GotesSCoop/ttn-boat-sensor/main/main.ino

/*

  Main module

  # Modified by Kyle T. Gabriel to fix issue with incorrect GPS data for TTNMapper

  Copyright (C) 2018 by Xose Pérez <xose dot perez at gmail dot com>

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
*/

#include "configuration.h"
#include "rom/rtc.h"
#include <TinyGPSPlus.h>
#include <Wire.h>
#include "DHT.h"


#include "axp20x.h"
AXP20X_Class axp;

DHT dht(DHTPIN, DHTTYPE);

bool pmu_irq = false;
String baChStatus = "No charging";

bool ssd1306_found = false;
bool axp192_found = false;

bool packetSent, packetQueued;
bool batt_connected = false;

float humidity;
float temp;
uint8_t switch_status;

static uint8_t txBuffer[10];

// deep sleep support
RTC_DATA_ATTR int bootCount = 0;
esp_sleep_source_t wakeCause;  // the reason we booted this time

// -----------------------------------------------------------------------------
// Application
// -----------------------------------------------------------------------------

float battVolt;

void buildPacket(uint8_t txBuffer[10])
/*
 * Packet structure is as follows
 * Bits 0..23 -> Latitude
 * Bits 24..47 -> Longitude
 * Bit 48 -> GPS Valid
 * Bits 49..55 -> Humidity
 * Bits 56..61 -> Temperature
 * Bit 62 -> Batery ON
 * Bit 63 -> Switch ON
 * Bits 64..71 -> Voltage battery
 * Bits 72..79 -> Not used
 */
{

    uint32_t LatitudeBinary;
    uint32_t LongitudeBinary;
    uint8_t hdopGps;
    uint8_t sats;
    
    uint8_t gpsValid;

    uint8_t humidityBinary;
    uint8_t tempBinary;
    float lowesttemp = -5;

    uint16_t vsens1 = 0;
    uint16_t vsens2 = 0;
    uint8_t battBinary;
    uint8_t battOn;
    
    char t[32]; // used to sprintf for Serial output

    // Battery
    battBinary = uint8_t(battVolt * 10);
    if (batt_connected) battOn = 1; else battOn=0;
    
    // GPS
    LatitudeBinary = ((gps_latitude() + 90) / 180.0) * 16777215;
    LongitudeBinary = ((gps_longitude() + 180) / 360.0) * 16777215;
    
    if ((gps_hdop() < 50.0) and batt_connected) gpsValid = 1; else gpsValid = 0;

    // DHT22     
    humidityBinary = (uint8_t)round(humidity);
    tempBinary = (uint8_t)(round(temp)-lowesttemp);

    // DEBUG
    sprintf(t, "GPS Valid: %d", gpsValid);
    Serial.println(t);
    sprintf(t, "Lat: %f", gps_latitude());
    Serial.println(t);
    sprintf(t, "Lng: %f", gps_longitude());
    Serial.println(t);
    sprintf(t, "Switch Status: %d", switch_status);
    Serial.println(t);
    sprintf(t, "Humidity Binary: %d", humidityBinary);
    Serial.println(t);    
    sprintf(t, "Humidity: %f", humidity);
    Serial.println(t);
    sprintf(t, "Temperature Binary: %d", tempBinary);
    Serial.println(t);  
    sprintf(t, "Temperature: %f", temp);
    Serial.println(t);
    sprintf(t, "Voltage sensor 1 IN : %f",  battVolt);
    Serial.println(t);  
    sprintf(t, "Batt Binary: %i", battBinary);
    Serial.println(t);  
    sprintf(t, "Batt On: %i", battOn);
    Serial.println(t);

    uint8_t txbfdbg = ((gpsValid<<7) & 0x80) | (humidityBinary & 0x7F);
    Serial.printf("TX BUFF 6: %i\n", txbfdbg);
    txbfdbg = ((tempBinary<<2) & 0xFC) | ((battOn << 1) & 0x02) | ((switch_status) & 0x01) ;
    Serial.printf("TX BUFF 7: %i\n", txbfdbg);
    
    // PACKET CREATION
    txBuffer[0] = ( LatitudeBinary >> 16 ) & 0xFF;
    txBuffer[1] = ( LatitudeBinary >> 8 ) & 0xFF;
    txBuffer[2] = LatitudeBinary & 0xFF;
    txBuffer[3] = ( LongitudeBinary >> 16 ) & 0xFF;
    txBuffer[4] = ( LongitudeBinary >> 8 ) & 0xFF;
    txBuffer[5] = LongitudeBinary & 0xFF;
    txBuffer[6] = ((gpsValid<<7) & 0x80) | (humidityBinary & 0x7F);
    txBuffer[7] = ((tempBinary<<2) & 0xFC) | ((battOn << 1) & 0x02) | ((switch_status) & 0x01) ;
    txBuffer[8] = battBinary;
    txBuffer[9] = 0x6A;
    
}

/**
 * If we have a valid position send it to the server.
 * @return true if we decided to send.
 */
bool trySend() {
    packetSent = false;
    char buffer[40];
    
    // Check if we send GPS data, only switch data, or both
    if (isGPSReady() or batt_connected==false){
      if (batt_connected == true){
        Serial.println("Gps wait done");
        snprintf(buffer, sizeof(buffer), "Latitude: %10.6f\n", gps_latitude());
        screen_print(buffer);
        snprintf(buffer, sizeof(buffer), "Longitude: %10.6f\n", gps_longitude());
        screen_print(buffer);
      }
      
      #if LORAWAN_CONFIRMED_EVERY > 0
        bool confirmed = (ttn_get_count() % LORAWAN_CONFIRMED_EVERY == 0);
        if (confirmed){ Serial.println("confirmation enabled"); }
      #else
        bool confirmed = false;
      #endif
            
      buildPacket(txBuffer);
      packetQueued = true;
      ttn_send(txBuffer, sizeof(txBuffer), LORAWAN_PORT, confirmed);
      
      return true;
    } else {
      // Inputs are not ready. Not sending anything yet
      return false;
    }
}


void doDeepSleep(uint64_t msecToWake)
{
    Serial.printf("Entering deep sleep for %llu seconds\n", msecToWake / 1000);

    // not using wifi yet, but once we are this is needed to shutoff the radio hw
    // esp_wifi_stop();

    screen_off();  // datasheet says this will draw only 10ua
    LMIC_shutdown();  // cleanly shutdown the radio
    
    if(axp192_found) {
        // turn on after initial testing with real hardware
        axp.setPowerOutPut(AXP192_LDO2, AXP202_OFF);  // LORA radio
        axp.setPowerOutPut(AXP192_LDO3, AXP202_OFF);  // GPS main power
    }

    // FIXME - use an external 10k pulldown so we can leave the RTC peripherals powered off
    // until then we need the following lines
    esp_sleep_pd_config(ESP_PD_DOMAIN_RTC_PERIPH, ESP_PD_OPTION_ON);

    // Only GPIOs which are have RTC functionality can be used in this bit map: 0,2,4,12-15,25-27,32-39.
    uint64_t gpioMask = (1ULL << BUTTON_PIN);

    // FIXME change polarity so we can wake on ANY_HIGH instead - that would allow us to use all three buttons (instead of just the first)
    gpio_pullup_en((gpio_num_t) BUTTON_PIN);

    esp_sleep_enable_ext1_wakeup(gpioMask, ESP_EXT1_WAKEUP_ALL_LOW);

    esp_sleep_enable_timer_wakeup(msecToWake * 1000ULL);  // call expects usecs
    esp_deep_sleep_start();                               // TBD mA sleep current (battery)
}


void sleep() {
#if SLEEP_BETWEEN_MESSAGES

    // If the user has a screen, tell them we are about to sleep
    if (ssd1306_found) {
        // Show the going to sleep message on the screen
        char buffer[20];
        snprintf(buffer, sizeof(buffer), "Sleeping in %3.1fs\n", (MESSAGE_TO_SLEEP_DELAY / 1000.0));
        screen_print(buffer);

        // Wait for MESSAGE_TO_SLEEP_DELAY millis to sleep
        delay(MESSAGE_TO_SLEEP_DELAY);

        // Turn off screen
        screen_off();
    }

    // Set the user button to wake the board
    sleep_interrupt(BUTTON_PIN, LOW);

    // We sleep for the interval between messages minus the current millis
    // this way we distribute the messages evenly every SEND_INTERVAL millis
    uint32_t sleep_for = (millis() < SEND_INTERVAL) ? SEND_INTERVAL - millis() : SEND_INTERVAL;
    doDeepSleep(sleep_for);

#endif
}


void callback(uint8_t message) {
    bool ttn_joined = false;
    if (EV_JOINED == message) {
        ttn_joined = true;
    }
    if (EV_JOINING == message) {
        if (ttn_joined) {
            screen_print("TTN joining...\n");
        } else {
            screen_print("Joined TTN!\n");
        }
    }
    if (EV_JOIN_FAILED == message) screen_print("TTN join failed\n");
    if (EV_REJOIN_FAILED == message) screen_print("TTN rejoin failed\n");
    if (EV_RESET == message) screen_print("Reset TTN connection\n");
    if (EV_LINK_DEAD == message) screen_print("TTN link dead\n");
    if (EV_ACK == message) screen_print("ACK received\n");
    if (EV_PENDING == message) screen_print("Message discarded\n");
    if (EV_QUEUED == message) screen_print("Message queued\n");

    // We only want to say 'packetSent' for our packets (not packets needed for joining)
    if (EV_TXCOMPLETE == message && packetQueued) {
        screen_print("Message sent\n");
        packetQueued = false;
        packetSent = true;
    }

    if (EV_RESPONSE == message) {
        screen_print("[TTN] Response: ");

        size_t len = ttn_response_len();
        uint8_t data[len];
        ttn_response(data, len);

        char buffer[6];
        for (uint8_t i = 0; i < len; i++) {
            snprintf(buffer, sizeof(buffer), "%02X", data[i]);
            screen_print(buffer);
        }
        screen_print("\n");
    }
}


void scanI2Cdevice(void)
{
    byte err, addr;
    int nDevices = 0;
    for (addr = 1; addr < 127; addr++) {
        Wire.beginTransmission(addr);
        err = Wire.endTransmission();
        if (err == 0) {
            Serial.print("I2C device found at address 0x");
            if (addr < 16)
                Serial.print("0");
            Serial.print(addr, HEX);
            Serial.println(" !");
            nDevices++;

            if (addr == SSD1306_ADDRESS) {
                ssd1306_found = true;
                Serial.println("ssd1306 display found");
            }
            if (addr == AXP192_SLAVE_ADDRESS) {
                axp192_found = true;
                Serial.println("axp192 PMU found");
            }
        } else if (err == 4) {
            Serial.print("Unknow error at address 0x");
            if (addr < 16)
                Serial.print("0");
            Serial.println(addr, HEX);
        }
    }
    if (nDevices == 0)
        Serial.println("No I2C devices found\n");
    else
        Serial.println("done\n");
}

/**
 * Init the power manager chip
 * 
 * axp192 power 
    DCDC1 0.7-3.5V @ 1200mA max -> OLED  // If you turn this off you'll lose comms to the axp192 because the OLED and the axp192 share the same i2c bus, instead use ssd1306 sleep mode
    DCDC2 -> unused
    DCDC3 0.7-3.5V @ 700mA max -> ESP32 (keep this on!)
    LDO1 30mA -> charges GPS backup battery  // charges the tiny J13 battery by the GPS to power the GPS ram (for a couple of days), can not be turned off
    LDO2 200mA -> LORA
    LDO3 200mA -> GPS
 */

void axp192Init() {
    if (axp192_found) {
        if (!axp.begin(Wire, AXP192_SLAVE_ADDRESS)) {
            Serial.println("AXP192 Begin PASS");
        } else {
            Serial.println("AXP192 Begin FAIL");
        }
        // axp.setChgLEDMode(LED_BLINK_4HZ);
        Serial.printf("DCDC1: %s\n", axp.isDCDC1Enable() ? "ENABLE" : "DISABLE");
        Serial.printf("DCDC2: %s\n", axp.isDCDC2Enable() ? "ENABLE" : "DISABLE");
        Serial.printf("LDO2: %s\n", axp.isLDO2Enable() ? "ENABLE" : "DISABLE");
        Serial.printf("LDO3: %s\n", axp.isLDO3Enable() ? "ENABLE" : "DISABLE");
        Serial.printf("DCDC3: %s\n", axp.isDCDC3Enable() ? "ENABLE" : "DISABLE");
        Serial.printf("Exten: %s\n", axp.isExtenEnable() ? "ENABLE" : "DISABLE");
        Serial.println("----------------------------------------");
        axp.setPowerOutPut(AXP192_LDO2, AXP202_ON);  // LORA radio
        axp.setPowerOutPut(AXP192_LDO3, AXP202_ON);  // GPS main power
        axp.setPowerOutPut(AXP192_DCDC2, AXP202_ON);
        axp.setPowerOutPut(AXP192_EXTEN, AXP202_ON);
        axp.setPowerOutPut(AXP192_DCDC1, AXP202_ON);
        axp.setDCDC1Voltage(3300);  // for the OLED power

        Serial.printf("DCDC1: %s\n", axp.isDCDC1Enable() ? "ENABLE" : "DISABLE");
        Serial.printf("DCDC2: %s\n", axp.isDCDC2Enable() ? "ENABLE" : "DISABLE");
        Serial.printf("LDO2: %s\n", axp.isLDO2Enable() ? "ENABLE" : "DISABLE");
        Serial.printf("LDO3: %s\n", axp.isLDO3Enable() ? "ENABLE" : "DISABLE");
        Serial.printf("DCDC3: %s\n", axp.isDCDC3Enable() ? "ENABLE" : "DISABLE");
        Serial.printf("Exten: %s\n", axp.isExtenEnable() ? "ENABLE" : "DISABLE");

        pinMode(PMU_IRQ, INPUT_PULLUP);
        attachInterrupt(PMU_IRQ, [] {
            pmu_irq = true;
        }, FALLING);

        axp.adc1Enable(AXP202_BATT_CUR_ADC1, 1);
        axp.enableIRQ(AXP202_VBUS_REMOVED_IRQ | AXP202_VBUS_CONNECT_IRQ | AXP202_BATT_REMOVED_IRQ | AXP202_BATT_CONNECT_IRQ, 1);
        axp.clearIRQ();

        if (axp.isChargeing()) {
            baChStatus = "Charging";
        }
            
    } else {
        Serial.println("AXP192 not found");
    }
}


// Perform power on init that we do on each wake from deep sleep
void initDeepSleep() {
    bootCount++;
    wakeCause = esp_sleep_get_wakeup_cause(); 
    /* 
    Not using yet because we are using wake on all buttons being low

    wakeButtons = esp_sleep_get_ext1_wakeup_status();        // If one of these buttons is set it was the reason we woke
    if (wakeCause == ESP_SLEEP_WAKEUP_EXT1 && !wakeButtons)  // we must have been using the 'all buttons rule for waking' to support busted boards, assume button one was pressed
        wakeButtons = ((uint64_t)1) << buttons.gpios[0];
    */

    Serial.printf("booted, wake cause %d (boot count %d)\n", wakeCause, bootCount);
}


void setup()
{
    // Debug
    #ifdef DEBUG_PORT
        DEBUG_PORT.begin(SERIAL_BAUD);
    #endif

    initDeepSleep();

    Wire.begin(I2C_SDA, I2C_SCL);
    scanI2Cdevice();

    axp192Init();

    // Buttons & LED
    pinMode(BUTTON_PIN, INPUT_PULLUP);

    dht.begin();

    #ifdef LED_PIN
        pinMode(LED_PIN, OUTPUT);
        digitalWrite(LED_PIN, HIGH);
    #endif

    // Hello
    DEBUG_MSG(APP_NAME " " APP_VERSION "\n");



    // Get battery status
    battVolt=getBoatBatt(VSENS2PIN);

    // Init GPS
    // Only initGPS if we're connected to power source
    if (isBattConnected(battVolt)) {
       Serial.println("Connected to power source. Init GPS");
       batt_connected = true;
       gps_setup();
    }
   

    // Don't init display if we don't have one or we are waking headless due to a timer event
    if (wakeCause == ESP_SLEEP_WAKEUP_TIMER)
        ssd1306_found = false;  // forget we even have the hardware

    if (ssd1306_found) screen_setup();    

    // Show logo on first boot after removing battery
    #ifndef ALWAYS_SHOW_LOGO
    if (bootCount == 1) {
    #endif
        screen_print(APP_NAME " " APP_VERSION, 0, 0);
        screen_show_logo();
        screen_update();
        delay(LOGO_DELAY);
    #ifndef ALWAYS_SHOW_LOGO
    }
    #endif
    // TTN setup
    if (!ttn_setup()) {
        screen_print("[ERR] Radio module not found!\n");

        if (REQUIRE_RADIO) {
            delay(MESSAGE_TO_SLEEP_DELAY);
            screen_off();
            sleep_forever();
        }
    }
    else {
        ttn_register(callback);
        ttn_join();
        ttn_adr(LORAWAN_ADR);
    }

    pinMode(SWITCH_PIN, INPUT);

    // get sensor values at the beggining to print it on screen
    humidity = dht.readHumidity();
    temp = dht.readTemperature();
    switch_status = digitalRead(SWITCH_PIN);
    
    char buffer[40];
    if (switch_status == 0) {
        snprintf(buffer, sizeof(buffer), "Switch OFF. Btt volt %.1fv\n", battVolt);
    } else {
      snprintf(buffer, sizeof(buffer), "Switch ON! Btt volt %.1fv\n", battVolt);
    }
    screen_print(buffer);

}

void loop() {
  
    if (isBattConnected(battVolt)){
       gps_loop();
       batt_connected = true;
    }
    
    ttn_loop();
    screen_loop();

    if (packetSent) {
        packetSent = false;
        sleep();
    }

    static bool wasPressed = false;
    static uint32_t minPressMs;     
    // if user presses button for more than 3 secs, discard our network prefs and reboot (FIXME, use a debounce lib instead of this boilerplate)
    if (!digitalRead(BUTTON_PIN)) {
        if (!wasPressed) {
            // just started a new press
            Serial.println("pressing");
            wasPressed = true;
            minPressMs = millis() + 3000;
        }
    }
    else if (wasPressed) {
        // we just did a release
        wasPressed = false;
        if (millis() > minPressMs) {
            // held long enough
            #ifndef PREFS_DISCARD
                screen_print("Discarding prefs disabled\n");
            #endif

            #ifdef PREFS_DISCARD
                screen_print("Discarding prefs!\n");
                ttn_erase_prefs();
                delay(5000);  // Give some time to read the screen
                ESP.restart();
            #endif
        }
    }

    /* We will always send a message just after we get valid inputs
     * (refer to functions isGPSReady() and isSwitchReadReady()) 
     * so we only need to put board to sleep after packetSent is true.
     * We send a message after SEND_INTERVAL millis, even if we don't
     * have valid GPS data
     */
    
    static uint32_t last = 0;
    static bool first = true;
    
    if (0 == last || millis() - last > SEND_INTERVAL) {
    // we are on SEND_INTERVAL. We check if inputs are ready.
    // if they are we send data via lora and go to sleep at next loop() iteration
    // if they are not simply pass
        if (trySend()) {
            last = millis();
            first = false;
            Serial.println("TRANSMITTED");
        }
        else {
            if (first) {
                screen_print("Waiting GPS and IO lock \n");
                first = false;           
            }
            // No GPS lock yet, let the OS put the main CPU in low power mode for 100ms (or until another interrupt comes in)
            // i.e. don't just keep spinning in loop as fast as we can.
            delay(100);
        }
    }
}
