GotesSCoop/ttn-boat-sensor/main/configuration.h

/*

TTGO T-BEAM Tracker for The Things Network

Copyright (C) 2018 by Xose Pérez <xose dot perez at gmail dot com>

This code requires LMIC library by Matthijs Kooijman
https://github.com/matthijskooijman/arduino-lmic

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
*/

// FREE PINS: 13,15,36,39

#pragma once

#include <Arduino.h>
#include <lmic.h>
void ttn_register(void (*callback)(uint8_t message));

// -----------------------------------------------------------------------------
// Version
// -----------------------------------------------------------------------------

#define APP_NAME                "FRANCESC XAVIER"
#define APP_VERSION             "1.0"

// -----------------------------------------------------------------------------
// Configuration
// -----------------------------------------------------------------------------

// Select which T-Beam board is being used. Only uncomment one.
//#define T_BEAM_V07  // AKA Rev0 (first board released)
#define T_BEAM_V10  // AKA Rev1 (second board released)

// If using a single-channel gateway, uncomment this next option and set to your gateway's channel
//#define SINGLE_CHANNEL_GATEWAY  0

//Uncomment if you always want to see the boot logo at boot time
#define ALWAYS_SHOW_LOGO

//Uncomment to enable discarding network settings by long pressing second button
#define PREFS_DISCARD

// If you are having difficulty sending messages to TTN after the first successful send,
// uncomment the next option and experiment with values (~ 1 - 5)
//#define CLOCK_ERROR             5

#define DEBUG_PORT              Serial          // Serial debug port
#define SERIAL_BAUD             115200          // Serial debug baud rate
#define SLEEP_BETWEEN_MESSAGES  true           // Do sleep between messages
#define SEND_INTERVAL           (300 * 1000)     // Sleep for these many millis. 300
#define MESSAGE_TO_SLEEP_DELAY  5000            // Time after message before going to sleep
#define LOGO_DELAY              5000            // Time to show logo on first boot
#define LORAWAN_PORT            10              // Port the messages will be sent to
#define LORAWAN_CONFIRMED_EVERY 0               // Send confirmed message every these many messages (0 means never)
#define LORAWAN_SF              DR_SF10         // Spreading factor (recommended DR_SF7 for ttn network map purposes, DR_SF10 works for slow moving trackers)
#define LORAWAN_ADR             0               // Enable ADR
#define REQUIRE_RADIO           true            // If true, we will fail to start if the radio is not found

// If not defined, we will wait for lock forever
#define GPS_WAIT_FOR_LOCK       (60 * 1000)     // Wait after every boot for GPS lock (may need longer than 5s because we turned the gps off during deep sleep)
//60
// -----------------------------------------------------------------------------
// DEBUG
// -----------------------------------------------------------------------------

#ifdef DEBUG_PORT
#define DEBUG_MSG(...) DEBUG_PORT.printf( __VA_ARGS__ )
#else
#define DEBUG_MSG(...)
#endif

// -----------------------------------------------------------------------------
// Custom messages
// -----------------------------------------------------------------------------

#define EV_QUEUED       100
#define EV_PENDING      101
#define EV_ACK          102
#define EV_RESPONSE     103

// -----------------------------------------------------------------------------
// General
// -----------------------------------------------------------------------------

#define I2C_SDA         21
#define I2C_SCL         22

#if defined(T_BEAM_V07)
#define LED_PIN         14
#define BUTTON_PIN      39
#elif defined(T_BEAM_V10)
#define BUTTON_PIN      38
//#define LED_PIN         4
#endif

// GOTES IO
// -----------------------------------------------------------------------------
// DHT
// -----------------------------------------------------------------------------
#define DHTTYPE DHT22 
#define DHTPIN 13

// -----------------------------------------------------------------------------
// SWITCH 
// -----------------------------------------------------------------------------
#define SWITCH_PIN      15

// -----------------------------------------------------------------------------
// VOLT SENSOR 
// -----------------------------------------------------------------------------
// SENS1: battery voltage level
// SENS2: is battery connected
//#define VSENS1PIN 39 //VN
#define VSENS2PIN 36 //VP
#define VSENS_R1 30000.0
#define VSENS_R2 7500.0
#define BATT_OFF_THRESHOLD 5.0

// -----------------------------------------------------------------------------
// OLED
// -----------------------------------------------------------------------------

#define SSD1306_ADDRESS 0x3C

// -----------------------------------------------------------------------------
// GPS
// -----------------------------------------------------------------------------

#define GPS_SERIAL_NUM  1
#define GPS_BAUDRATE    9600
#define USE_GPS         1

#if defined(T_BEAM_V07)
#define GPS_RX_PIN      12
#define GPS_TX_PIN      15
#elif defined(T_BEAM_V10)
#define GPS_RX_PIN      34
#define GPS_TX_PIN      12
#endif

// -----------------------------------------------------------------------------
// LoRa SPI
// -----------------------------------------------------------------------------

#define SCK_GPIO        5
#define MISO_GPIO       19
#define MOSI_GPIO       27
#define NSS_GPIO        18
#if defined(T_BEAM_V10)
#define RESET_GPIO      14
#else
#define RESET_GPIO      23
#endif
#define DIO0_GPIO       26
#define DIO1_GPIO       33 // Note: not really used on this board
#define DIO2_GPIO       32 // Note: not really used on this board

// -----------------------------------------------------------------------------
// AXP192 (Rev1-specific options)
// -----------------------------------------------------------------------------

// #define AXP192_SLAVE_ADDRESS  0x34 // Now defined in axp20x.h
#define GPS_POWER_CTRL_CH     3
#define LORA_POWER_CTRL_CH    2
#define PMU_IRQ               35
