GotesSCoop/ttn-boat-sensor/(commit log)

2021-12-15 Untracked files issue resolved to fix .gitignore
    [configuration.h]
2021-12-15 Add working code
    [configuration.h]
2021-12-16 Add images and README
    [configuration.h]
2022-01-11 add battery changes and param tunning
    [configuration.h]
2022-04-21 add screen support
    [configuration.h]
